kirstinmeyer/CATAIN/Build_resources/BLOCK.bmp

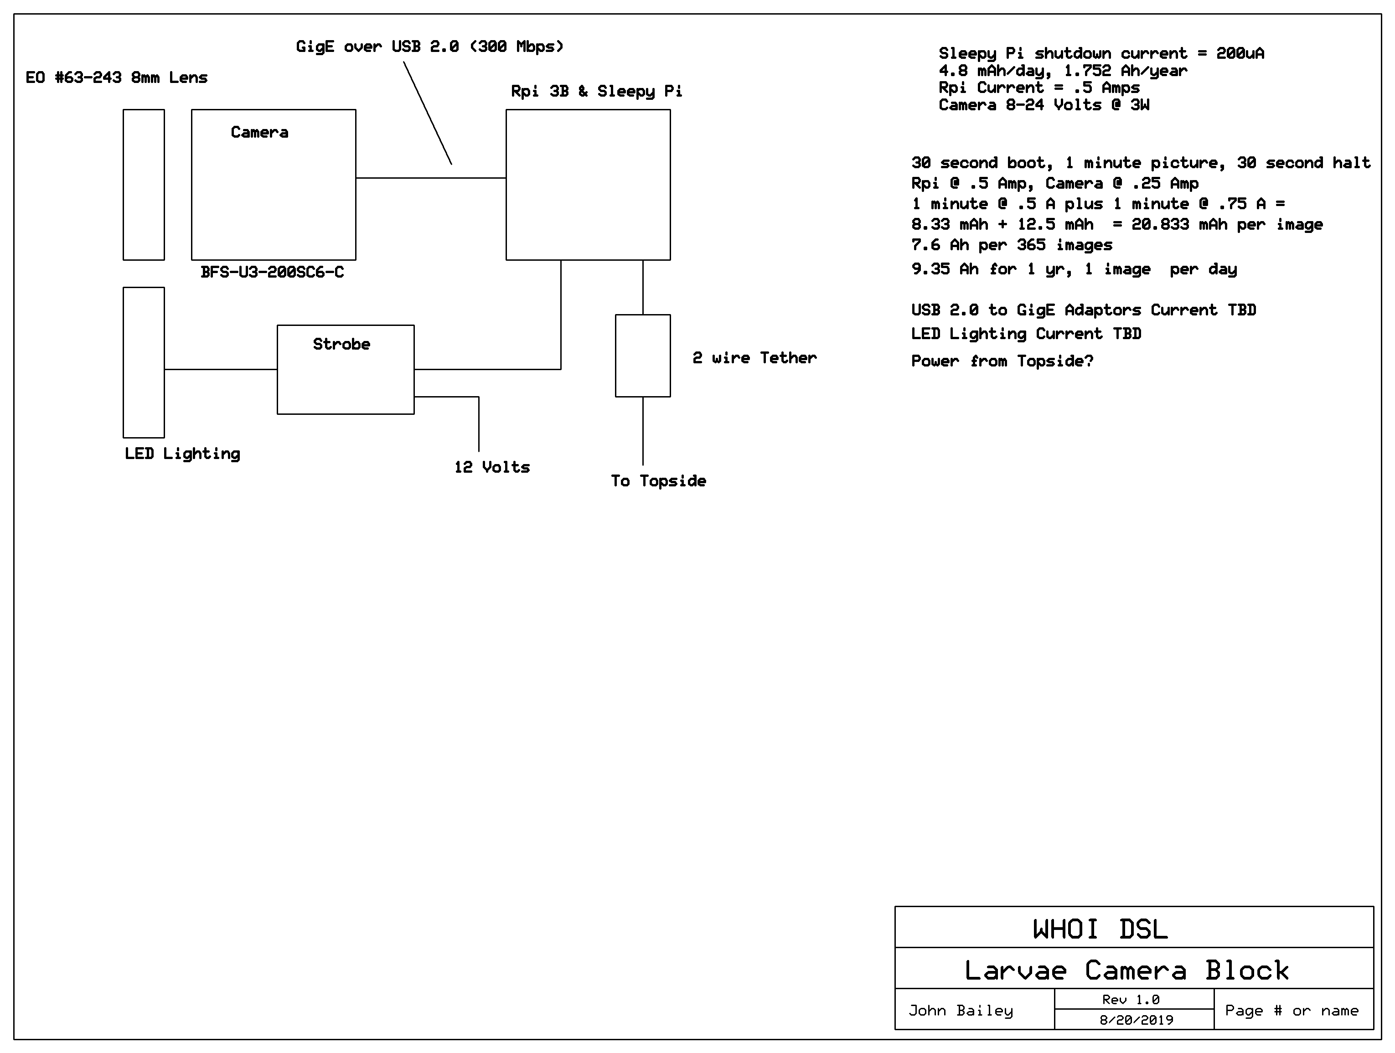
Build_resources/BLOCK.bmp
