kirstinmeyer/CATAIN/Build_resources/Strobe.bmp

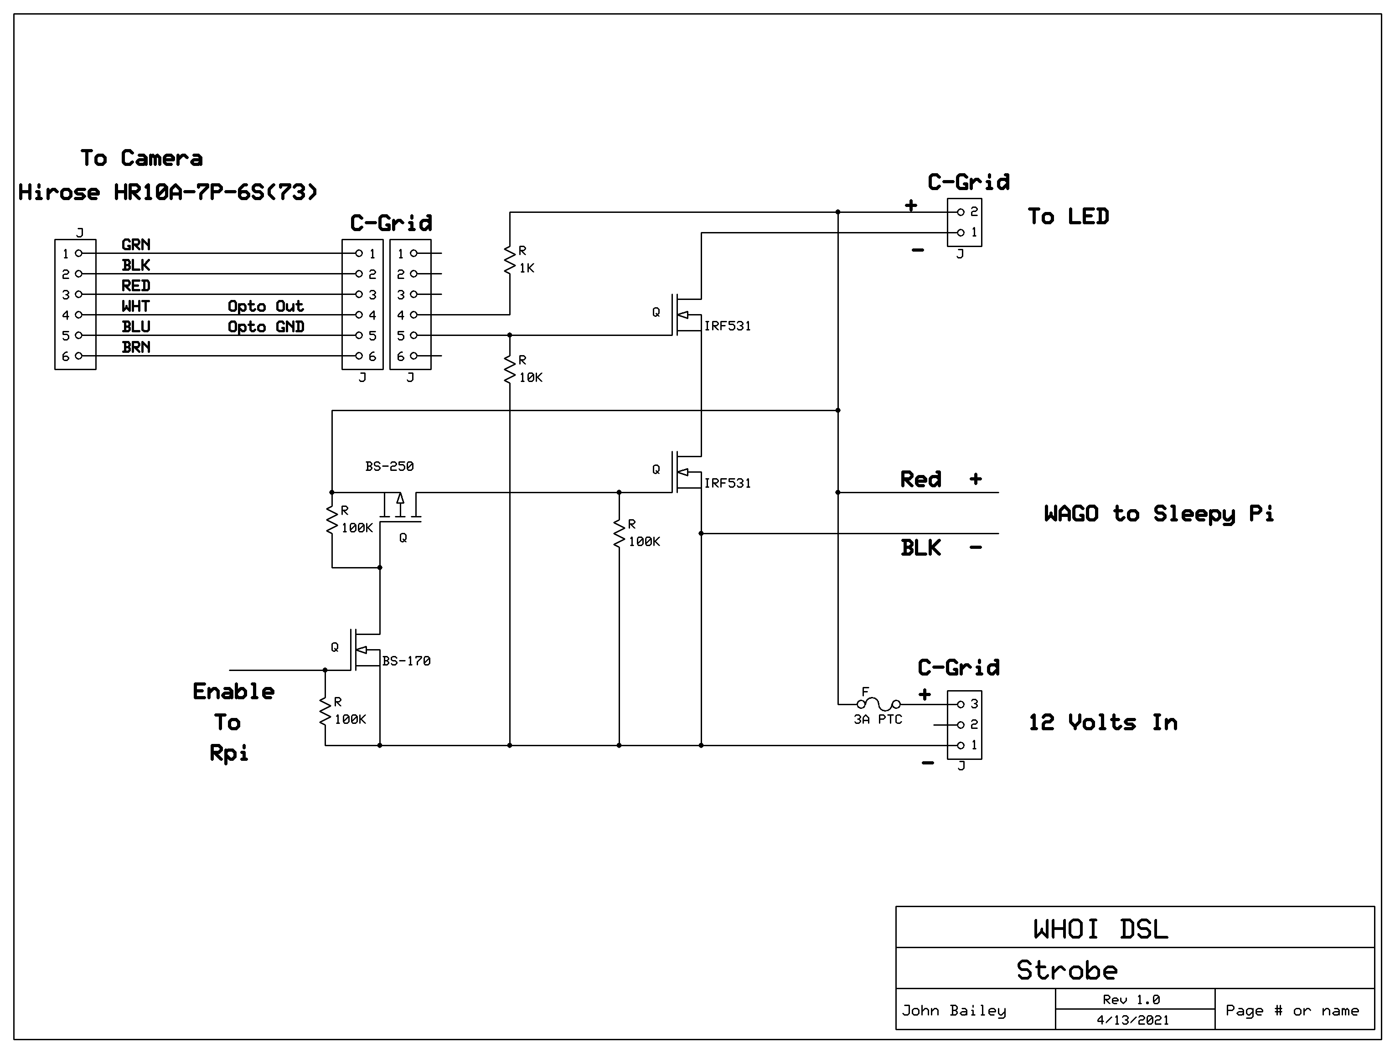
Build_resources/Strobe.bmp
